jpsheehan/ence461-assignment2/README.md

# ence461_assignment2
2020 ENCE461 Assignment 2
