jpsheehan/ence461-assignment2/report/appendix.tex

\newpage
\appendix

\section*{Appendices}

\input{appendix-conditioning}

\input{appendix-thermal}

\input{appendix-schematic}

\input{appendix-bom}
