jpsheehan/ence461-assignment2/report/appendix-schematic.tex

\section{Schematic}
\label{ap:schematic}

The system schematic is included in the following page.

\includepdf[pages=1,fitpaper]{includes/ence461_kicad.pdf}
