jpsheehan/ence461-assignment2/report/design.tex

\section{Design}

\input{design-power-supply}

\input{design-amplifier-stage}

\input{design-microcontroller}

\input{design-communications}

\input{design-pcb-layout}
