jpsheehan/ence461-assignment2/report/report.tex

% !TEX TS-program = pdflatex
% !TEX encoding = UTF-8 Unicode

%%%%%%%%%%%%%%%%%%%%%%%%%%%%%%%%%%%%%%%%%%%%%%%%%%%%%%%%%%%%%%%%%%%%%%%%%%%%%%%%
%%%%%%%%                        DOCUMENT PREAMBLE                       %%%%%%%%
%%%%%%%%%%%%%%%%%%%%%%%%%%%%%%%%%%%%%%%%%%%%%%%%%%%%%%%%%%%%%%%%%%%%%%%%%%%%%%%%

\documentclass[12pt]{article}

\usepackage[utf8]{inputenc}

%%% PAGE DIMENSIONS
\usepackage{geometry}
\geometry{a4paper}
\geometry{margin=1in}

%%% PACKAGES
\usepackage{booktabs} 		% for much better looking tables
\usepackage{array} 			% for better arrays (eg matrices) in maths
\usepackage{paralist} 		% very flexible & customisable lists (eg. enumerate/itemize, etc.)
\usepackage{verbatim} 		% adds environment for commenting out blocks of text & for better verbatim
\usepackage{caption}
\usepackage{subcaption} 		% make it possible to include more than one captioned figure/table in a single float
\usepackage{amsmath}		% gives math environments like align, split, etc
\usepackage[parfill]{parskip} % Activate to begin paragraphs with an empty line rather than an indent
\usepackage{xcolor}			% adds support for different colors
\usepackage{float}			% adds support for floats
\usepackage{upgreek}		% greek letters
\usepackage{amssymb}
\usepackage{url}
\usepackage[binary-units]{siunitx}
\usepackage{pdfpages}

%%% Images
\usepackage{graphicx}		% allows us to include images
\graphicspath{ {./images/} }

%%% HEADERS & FOOTERS
\usepackage{fancyhdr} 		% This should be set AFTER setting up the page geometry
\pagestyle{fancy}
\renewcommand{\headrulewidth}{0pt} % customise the layout...
\lhead{}\chead{}\rhead{}
\lfoot{}\cfoot{\thepage}\rfoot{}

%%% ToC (table of contents) APPEARANCE
% \usepackage[nottoc,notlof,notlot]{tocbibind} % Put the bibliography in the ToC
% \usepackage[titles,subfigure]{tocloft} % Alter the style of the Table of Contents
% \renewcommand{\cftsecfont}{\rmfamily\mdseries\upshape}
% \renewcommand{\cftsecpagefont}{\rmfamily\mdseries\upshape} % No bold!

%%% Referencing and Bibliography
\usepackage[backend=bibtex, style=ieee]{biblatex}
\addbibresource{references.bib}

%%% Title Stuff
\title{ENCE461 Assignment 2}
\author{
	J.P. Sheehan \\
	M.F. Hamblyn \\
	\small{Group 36}
}
\date{\today}

%%%%%%%%%%%%%%%%%%%%%%%%%%%%%%%%%%%%%%%%%%%%%%%%%%%%%%%%%%%%%%%%%%%%%%%%%%%%%%%%
%%%%%%%%                          DOCUMENT BODY                         %%%%%%%%
%%%%%%%%%%%%%%%%%%%%%%%%%%%%%%%%%%%%%%%%%%%%%%%%%%%%%%%%%%%%%%%%%%%%%%%%%%%%%%%%

\begin{document}
\maketitle
\thispagestyle{empty}

\vfill
\begin{figure}[H]
	\centering
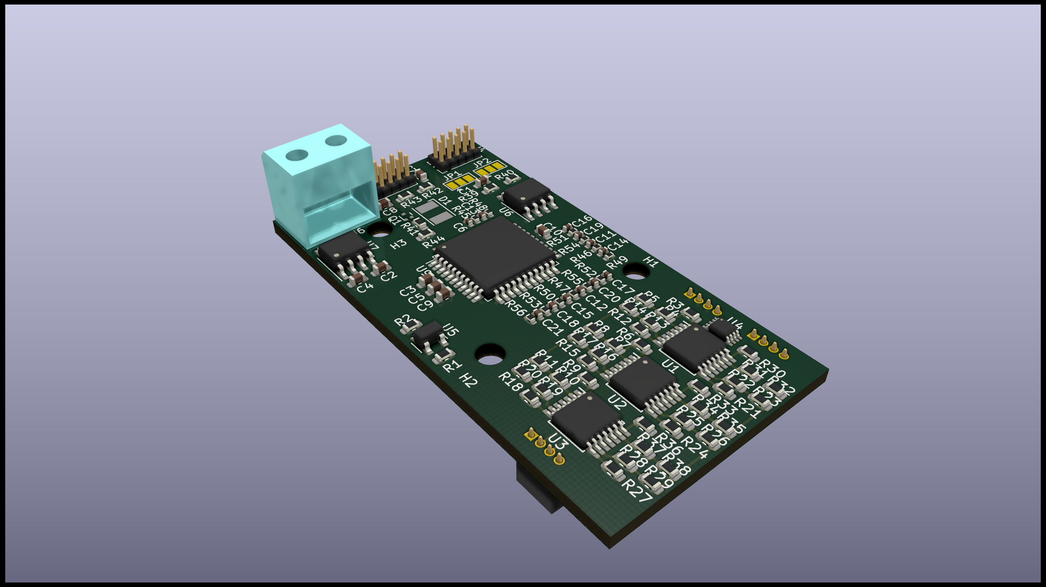
[picture p11: report/images/render.png]
	
	\label{fig:render}
\end{figure}
\vfill

\newpage

\input{introduction}

\input{design}

\input{conclusion}

%%%%%%%%%%%%%%%%%%%%%%%%%%%%%%%%%%%%%%%%%%%%%%%%%%%%%%%%%%%%%%%%%%%%%%%%%%%%%%%%
%%%%%%%%                           BIBLIOGRAPHY                         %%%%%%%%
%%%%%%%%%%%%%%%%%%%%%%%%%%%%%%%%%%%%%%%%%%%%%%%%%%%%%%%%%%%%%%%%%%%%%%%%%%%%%%%%

\printbibliography

% appendix
\input{appendix}

\end{document}
