jpsheehan/ence461-assignment2/report/introduction.tex

\section{Introduction}

Based on the provided requirements and subsequent clarifications, this design achieves:
\begin{enumerate}
	\item Reliable high speed, multi-node, communications.
	\item Minimal standby-mode power consumption.
	\item Ease of installation and maintainence. 
\end{enumerate}

The following sections outline the key design decisions made with a detailed analysis provided in the appendices.
