jpsheehan/ence461-assignment2/report/appendix-bom.tex

\section{Bill of Materials}
\label{ap:bom}

The bill of materials (BOM) including price list is included on the following page.
All prices are in NZD and all parts are sourced from Digi-Key\footnote{\url{https://www.digikey.co.nz/}}.

\includepdf[pages=1,fitpaper]{includes/BOM_cost.pdf}
