jpsheehan/ence461-assignment2/research/Parts.txt

Power Supply
Opamps are to be powered off 5V, a 2.5V (half rail) reference is required and we will assume, at this stage, microcontroller will be a 3.3V device. 
Therefore multiple supply rails are needed.
Optiom 1 - two seperate regulators
5V supply for the opamps and 1/2 rail.
May require the 5V and/or half rail to connect to micro ADC reference as well, but assume this rail does not require current.

5V supply to Opamp ADC amplifiers
Requirements
Linear device
5V output
>= 105 degrees
6V input.
RoHS comlaint
SMD
Ideally a low dropout voltage at full load. 
Minimum additional components
Missing parameter: ouput current.

Output current calculations
12 ADC channels and max current 2.7mA. Round up to 3mA gives some overhead.
Further opamp for the 2.5 volt reference. 13 x 3mA = 39mA.

Using the Digikey part sselector 
RoHSm datasheet, active part, 125 degrees, Vin max = 10V (allow some overhead for 6V input) gives:
1)
ADP1720ARMZ-R7
Datasheet ADP1720ARMZ-R7
Which has ouput current 50mA, VDO 275mV, -40 to 125 degree C
2)
Digikey 296-1364-2-ND, IC REG LINEAR 5V 100MA 8SOIC,
http://www.ti.com/general/docs/suppproductinfo.tsp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
3)
Digikey TC1054-5.0VCT713CT-ND, TC1054-5.0VCT713 
Datasheet http://ww1.microchip.com/downloads/en/DeviceDoc/21350E.pdf

Choose TC1054-5.0VCT713‎ because
Low drop out voltage (supply is only 6V and we need 5V out) typically 85mV max 120mV
It provies control pins. These may be required to shutdown the ADC amps into low power. (50uSec start up time for opamp)
Note that the ramp up time from shutdown to active is less than 100uSec. T start is therfore 100 + 50 = 150uSec
There are 100 and 150mA versions so if dicsover greater current is required this part can be uprated.

Thermal consderations.
PD worst case operating = (Vin - Vout) x Imax => (6.5-5)*50 = 75mW
PD max = (TJ - TA)/ thetaJA => (125-105) / 220 = 90.90mW
Thus PDMax > PD worst therfore device is suitable fro mthermal perspective.
However vin max = PD max/Imax + Vo => 90.909mW/50mA + 5 = 6.81V max.
Thus the supply input voltage must not exceed 6.8V, however Vin max is 6.5V.

93 units are required (assuming there is a need for 5V in the master unit)
Purhase of 100 units is reduces the cost by 20C and proves 7 spares
100x 0.46340 = $46.34

3.3V supply to microprocessor
Requirements
Linear devie since ADC is it main function.
3.3V output
>= 105 degrees
6V input.
RoHS compliantt
SMD
Minimum additional components
Mising parameter: ouput current
Output current calulations

If we assumed at this stage the micro and 3V3 periphials will comsume 500mA in total we can use CAT6219-330TDGT3 but 
 this is last time buy according to digikey and is likely overspecified.

Assume at this stage the micro and 3V3 periphials will comsume 150mA in total 
(micro, LED x 2, possbible buss chips)

Using the Digikey part sselector 
RoHSm datasheet, active part, 125 degrees, Vin max = 10V (allows overhead for 6V input) gives 

Selet the following part due to
Minimum external compents, on board protection.
Digikey 296-11021-1-ND, TPS76333DBVR
http://www.ti.com/lit/ds/symlink/tps763.pdf?HQS=TI-null-null-digikeymode-df-pf-null-wwe&ts=1590036136348
It is known that there are 6V versions and also 250mA versions whcih may have a similar form factor, 
 so the part could be changed if higher Iout is required.

Thermal consderations.
PD worst case operating = (Vin - Vout) x Imax => (6.5-3.3)V * 150mA = 480mW
PD max = (TJ - TA)/ thetaJA => (125-105) / 205.3 = 97.41 mW
Thus PDMax < PD worst therfore device is not suitable.

TPS76633, TPD706-150 and others => not suitable

Check
Digikey 296-19675-1-ND, TPS71733DCKR
Tj = Tt + gamma?jt * PD max => 105 + 2.7*480mW = 106.296 less than Toperating max = 125 
Tj = Tb + gamma?jb * PD max => 105 + 40.9* 480mW = 124.632 degress just less than Toperating max = 125 
This is on the limit at 6.5V input 
At 6.0 Vin Tj = 121 degrees - still less than Toperating max = 125 
VDO = 300mV worst case.
100 x 1.00190 =  $100.19 

Option 2 - combined 5V and 3V3 supplies
Maybe later

Op-Amps:
========

OPAMP FOR VIRTUAL GROUND: 296-51364-1-ND (digikey)

Option 1
Need 12 opamp circuits for each slave board.
and one more for reliable 1/2 rail.

The LMV324AIPWR has four opamp circuits per package.
So we only need 12 / 4 * 92 = 368 of these.
The part number on Digi-Key is [296-51366-1-ND ](https://www.digikey.co.nz/product-detail/en/texas-instruments/LMV324AIPWR/296-51366-1-ND/9745730).
For 368, we have a buy price of $0.36704 per unit

This part doesn't have an enable line so we will have to also use a mosfet to drive the positive supply voltage to ground to disable. 
This chip has a 50 us startup time.
Gets to within 20mV of rail voltage.

150uA * 13 devices = 1.95mA == 2mA ??

Option 2
MCP632T-E/MFCT-ND provides chip enable/disable function and T operating of 125 degress. Tmax is 150 degrees so based on the likely current ouputs with no 
 ouptput limiting resistor comfortabel meets the PD max and PO max thermal considerations.
Optimies for single supply rail.
Input current is nomianll6 2.5mA per channel and 3.6mA max per channel.
Enable time is 4.5uSec.
3.6mA x 13 = 46.8 mA - within 5V regulator specification.
Checking pricing 368 dual units at 1.483 ea is the lowest cost option at $545.70. 4 Opamps per board, 1 ch unused. (could put jumpers on this)
Gets to within 40mV of rail voltage.

Revised system
1)
5V devices		worst case	typical
ADC amplifiers	13 x 03mA	39	.6mA	9.75
Half rail	01 x 01mA	01	01	01
CAN driver	01 x 70mA	70	47mA	47
Hex inverter	01 x 50mA	50	50mA	50
=======================================================
Total				118		110

Thermal consderations - TPS76950DBVT
PD worst case operating = (Vin - Vout) x Imax => (6-5)*100m = 100mW
PD max = (TJ - TA)/ thetaJA => (125-105) / 180 = 110mW [Board must be design for high temperature operation JEDEC HighK (2s2p)] 
Thus PDMax > PD worst therfore device is suitable fro mthermal perspective.
But 110 > 100mA

2)
5V devices		worst case	typical
ADC amplifiers	13 x 03mA	39	.6mA	9.75
Half rail	01 x 01mA	01	01	01
CAN driver	01 x 70mA	70	47mA	47
Hex inverter	01 x 50mA	50	50mA	50
=======================================================
Total				118		110

Thermal consderations - TPS717DRV(WSON

PD worst case operating = (Vin - Vout) x Imax => (6-5)*110m = 110mW
Jt = Tj + Tt*PDmax => 105 + 2.7  x 120mW = 105 degrees C
Jt = Tj + Tt*PDmax => 105 + 40.9 x 120mW = 109 degrees C
Tj < Tj MAX (125 degrees) therfore device is suitable fro mthermal perspective.

3)
3V3 devices		worst case	typical
micro		01 x 40mA	40	01 x 50mA	30
LEDS		02 x 05mA	10	02 x 05mA	10
===========================================================
Total				50			40

PD worst case operating = (Vin - Vout) x Imax => (6-3.3)*50m = 135mW
PD Max = (Toperating-Tambient)/T JA => (125-105)/65 = 307mW
[Board must be design for high temperature operation JEDEC HighK (2s2p)] 

3V3 devices		worst case	typical
micro		01 x 80mA	80	01 x 50mA	50 30
LEDS		01 x 19mA	20	01 x 19mA	19
===========================================================
Total				100			70

TPS71433DRV
PD worst case = (Vin - Vout) x Imax => (6-3.3)*70m = 189mW
PD worst typical operating = (Vin - Vout) x Imax => (6-3.3)*30m = 81mW
PD max operating = (Vin - Vout) x Imax => (6-3.3)*80m = 216mW
[Board must be designed for high temperature operation JEDEC HighK (2s2p)] 

5V3 devices		worst case	typical
micro		11 x 40mA	40	30mA	30
LEDS		02 x 10mA	20	05mA	10
=======================================================
Total				60		40

Revision 17

CAN Transceiver
===============
NCV7344D13R2GOSCT-ND (digikey)

LED Indication
==============
Red LED: 475-2516-1-ND (digikey)
P MOSFET: RZM001P02T2LCT-ND (digikey)

Microcontroller
===============
ATSAMC21N17A-ANTCT-ND (digikey)

5V Regulator
============
Option 1)
Devices		worst case		typical
ADC amplifiers	13 x 03mA	39	.75mA	9.75
Half rail	01 x 01mA	01	01mA	01
CAN driver	01 x 70mA	70	47mA	47
Hex inverter	01 x 50mA	50	50mA	50
Micro		01 x 50mA	50	20mA	20
LED		01 x 19mA	19	19mA	19
=======================================================
Total				118		145.75

Thermal design TPS71750QDRVRQ1‎
PD worst case operating = (Vin - Vout) x Imax => (6-5)*145.75 = 145.75mW
Tj = Ta + Tt*PDmax => 105 + 2.7  x 146mW = 105.39 degrees C
Tj = Ta + Tt*PDmax => 105 + 40.9 x 146mW = 110 degrees C
Tj > Tj MAX (125 degrees) :. device is suitable from thermal perspective.
100 x 0.80411 = $80.41

option 2)
Devices		worst case		typical
ADC amplifiers	13 x 03mA	39	.75mA	9.75
Half rail	01 x 01mA	01	01mA	01
CAN driver	01 x 70mA	70	47mA	47
Micro		01 x 50mA	50	20mA	20
LED		01 x 19mA	19	19mA	19
=======================================================
Total				118		95.75
PD worst case operating = (Vin - Vout) x Imax => (6-5)*95.75 = 95.75mW
Tj > Tj MAX (125 degrees) (current reduced :. power reduced) :. device is suitable from thermal perspective.
100 x 0.80411 = $80.41

option 3)
Devices		worst case		typical
ADC amplifiers	13 x 03mA	39	.75mA	9.75
Half rail	01 x 01mA	01	.5mA	.5
CAN driver	01 x 70mA	70	47mA	47
Micro		01 x 50mA	50	20mA	20
LED		01 x 19mA	19	19mA	19
=======================================================
Total				118		95.25

PD worst case operating = (Vin - Vout) x Imax => (6-5) x 95.25 = 95.25mW
PD max = (T max - T ambient) / Theta JA => (125-105) / 65 = 317.46mW
PD < PDmax :. device is ok.
@ PD = (6-5)*145.75 = 145.75mW < PD max
100 x MIC5202-5.0YMM @ 2.33750 = 233.75 digikey
OR
100 x MIC5210-5.0YMM @ 1.87 = $187
!st option = less physcial space, 2nd option lower price.
a 5V amps on 1 rail, micro and CAN on other
b 5V amps & hex inverter 1 rail, micro and CAN on other
c 5V amps, hex and CAN, micro on other use CAN wake on Rx 

Cables and Connectors
============================================================

Power
------
150mA x 92 devices = 13.8 amps = > 19.2A
Split into 4 termainton points = 3.45 each at the point of supply. 4.8A if later expandto 128 nodes.
rATE SUPPLKY CONNECTORS AT 5a EACH.
Rate PSU cable to 2.9A based that cable will not run at full current for extended duration and 
only the sectsion of cable nearest the supply wil need to carry full current.
2.9A = 17AWG = 1.15mm = 1.04mm^2
Split power rails into 4 feeders. 92/4 = 23. 22 board interconnnects per feeder @ 160mm each = 3520mm = 3.52m.
Assume master is 10m from motherboard: 10m x 4feeders = 40m
40m + 3.52m = 43.52m => 50m 
Mouser: 
(2x 25m roll black + 2x 25m roll red or 2x 100 ft black, 2x 100ft red)
4x 148.50 (per 100ft) = $594
Digikey: 
(1x 50m roll black, 1x 50m roll red) 
2x 50m @ 195.55000 = $191.10
67010 BK321 Black
67010 RD321 Red

Choose
TB002-500-02BE .38930  x 100
based on price and requiremt to get 2x 17AWG conductors into the terminal block.

Alternative not used.
Plug 	691381000002 2.34860 x 100
Socket	691382000002 0.75070 x 100

Data
-----
Ribbon cable chosen for easy interconect, and speed.
10 way is more readily avialbel than 8 way.
10way IDC ribbon cable, crimped strain relief plug, through hole PCB mount, 0.05 inch 1.27 mm pitch
Split buss into 2 feeders. 92/2 = 46 units. 45 interconecnted at 160mm = 1360mm = 7.36m
Assume master is 10m from motherboard: 10m x 2 feeders = 20m
20m + 7.36m = 27.36 => 30.48m (100 ft)
Plug		3230-10-0103-00		$1.87 x 100
PCB socket	3221-10-0100-00		$.852 x 100
<<<<<<< HEAD
Cable		3756/10 100 		$1.15760 x 25

=======
Cable		3756/10 100 		$46.05000 x 1 = $46.05000
>>>>>>> 66b855b4c92f8af61c3a72c46185c5a99e1565bd
	Conductors size is 30AWG (nominally 270kHz for 100% skin depth)
	Actual cable uses 7 strands of 38AWG (nominally 1750kHz for 100% skin depth)
	Z characterist 138 ohms balenced, velocity factor 74%, velocity of prop 4.53nSec/m.
	(have chosen a cable with slight higher charestic impeedence to achvieve a signhlt higher voelcity factor, knowing
	 that the bus is near end and far end terminated to 120 ohm this actually presenr 130 ohm parallel.
	If needed this could be reduce this to 120 ohm by changing the buss termial reistor values.)
	coudl reduce the values of the resistors,)

Choose 00 AA 00 BB 00 (1-10) (2x buss conducters enclised surrounded by signal ground.
	This is chosen so that the cabel can be reversed without damage - only buss B is conencted in stead of buss A.
	Further, each data conductor has an signal gound condcutor next to it to minmise indcued noise.  
	(Optiontally termina lsignla ground to power groudn at the slave borads using a approate capacitor.)
Not 0 AA 0 BB 0 CC 0 (3 buss) or +0 AA 00 BB 0+ (power on bus)

The master unit.
4 power supply terminal blocks or simalr rated to 5A.
2 CAN bus ribbon cable terminations.

Jesse's Power Connector Search:
===============================

102-6145-ND about 0.38 each for 100
