jpsheehan/ence461-assignment2/ence461_kicad/models/terminalblock.FCStd

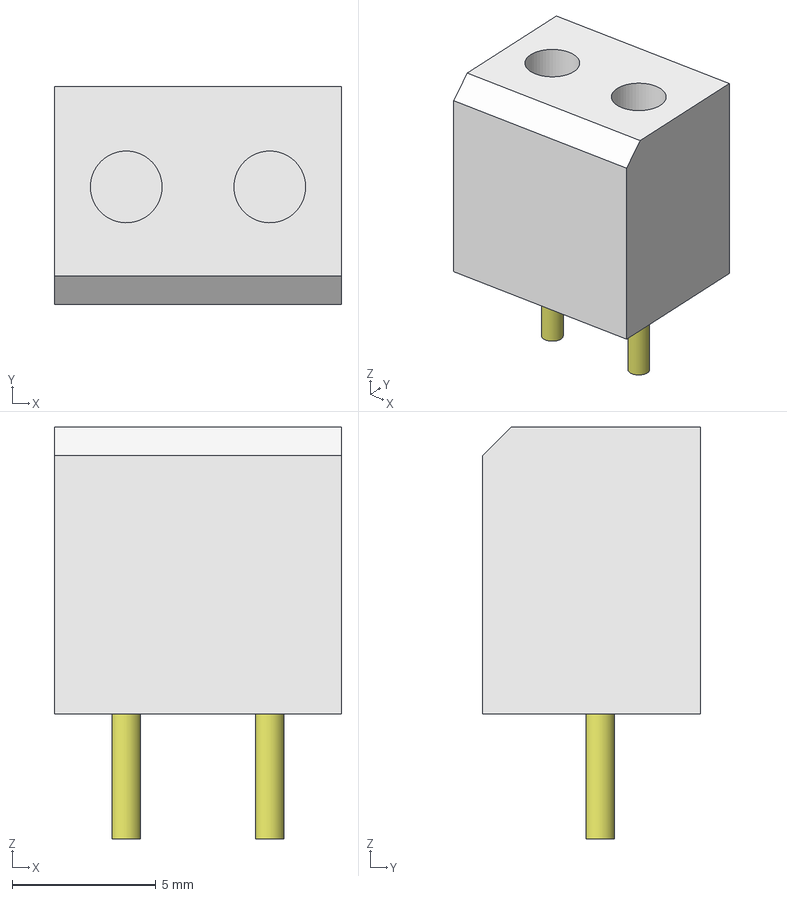
[picture p13: CAD file, 2020-05-24]
ence461_kicad/models/terminalblock.FCStd
10.0 x 7.60 x 14.3 mm
