jpsheehan/ence461-assignment2/report/includes/ence461_kicad.pdf

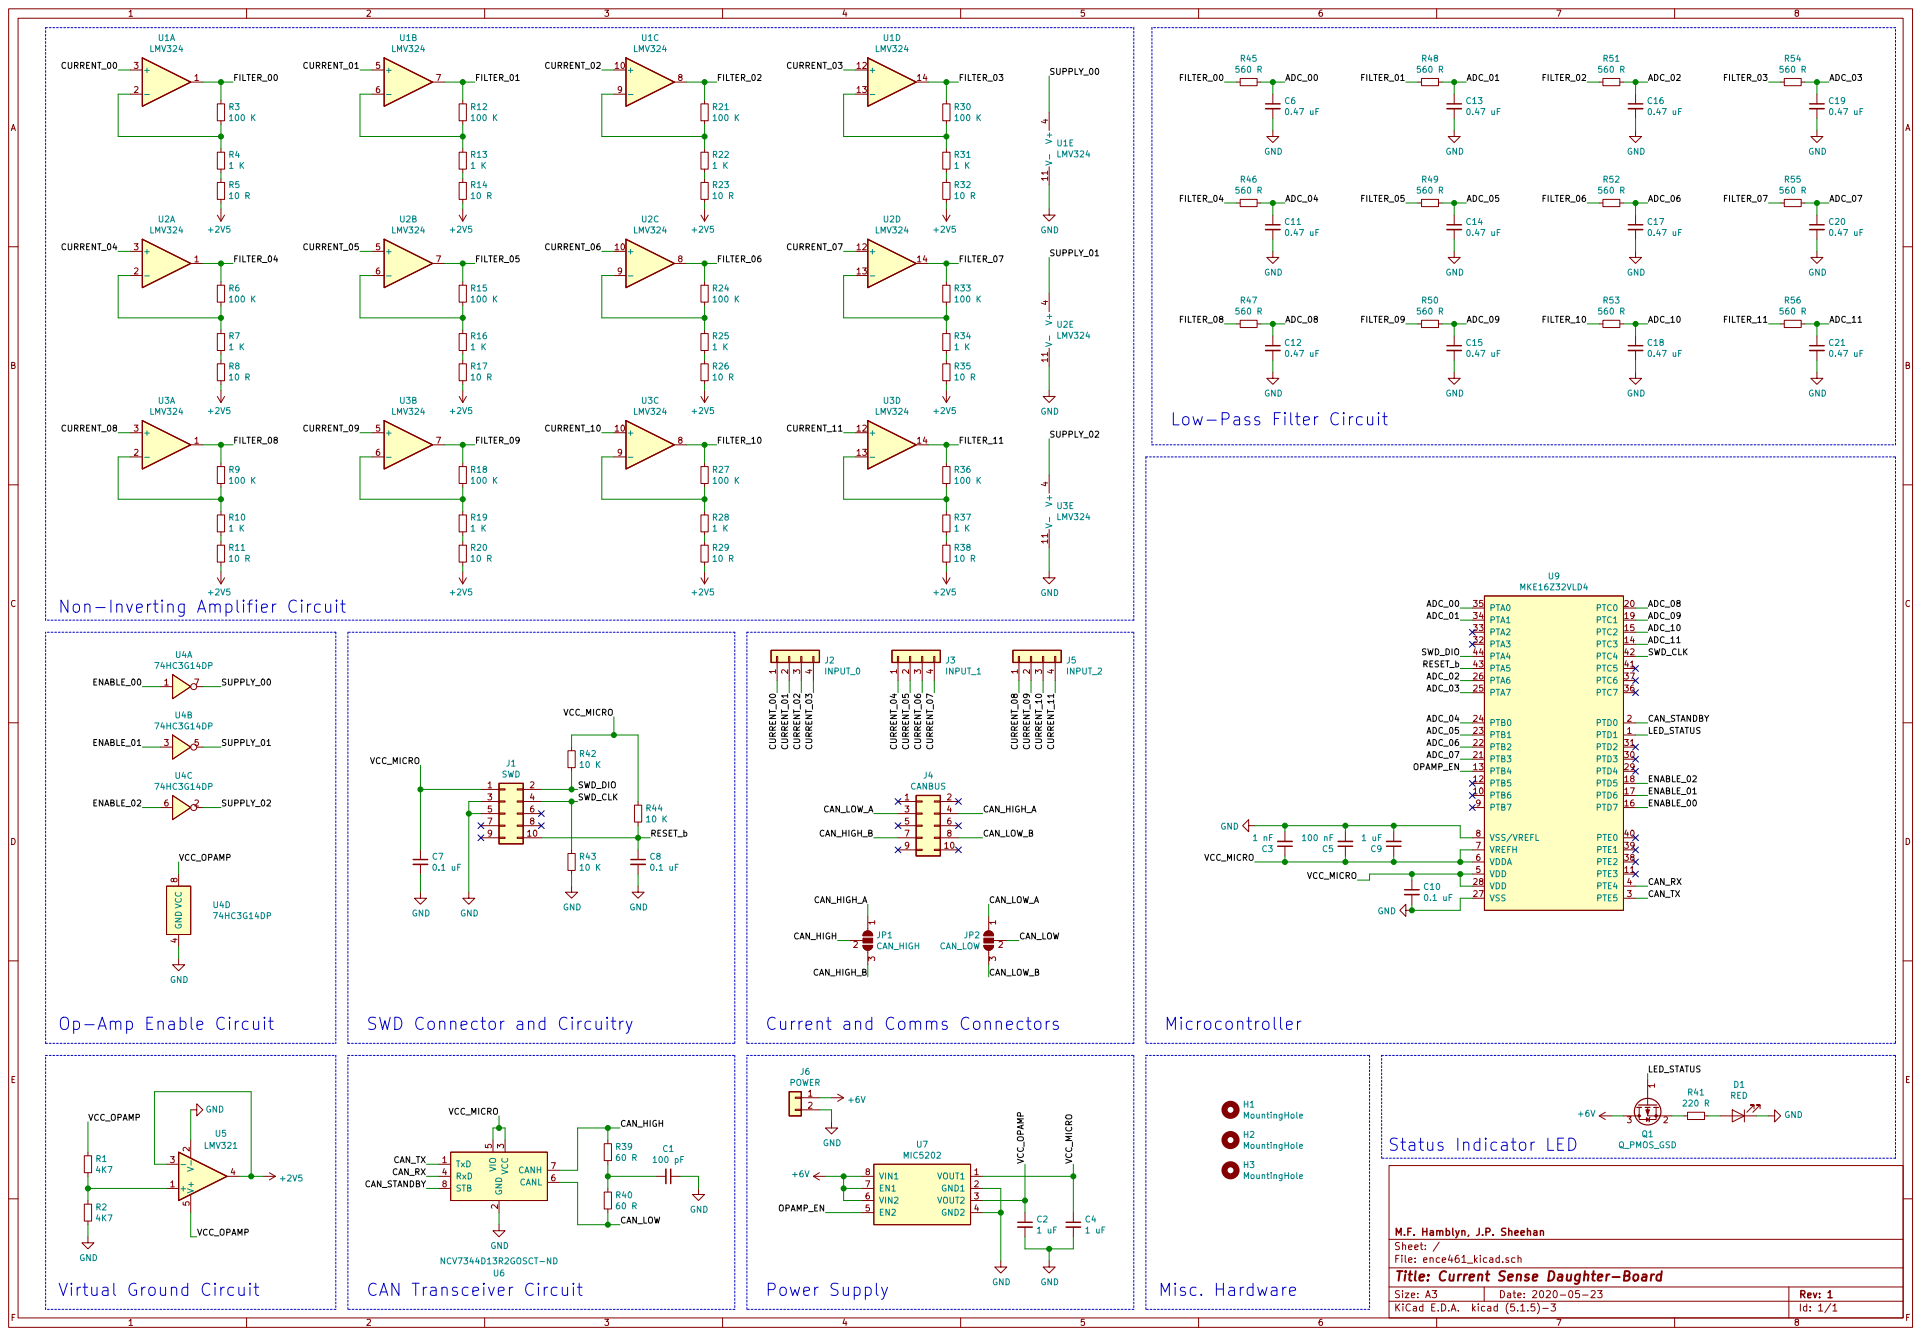
[picture p14: page 1]

Low-Pass Filter Circuit

LED_STATUS Non-Inverting Amplifier Circuit

5 CANL 6 CANH 7 STB 8 U6 NCV7344D13R2GOSCT-ND GNDGND

Current and Comms Connectors

File: ence461_kicad.sch Sheet: / M.F. Hamblyn, J.P. Sheehan

Id: 1/1 Title: Current Sense Daughter-Board
