jpsheehan/ence461-assignment2/ence461_kicad/ence461_kicad.kicad_pcb

## KiCad design ence461_kicad/ence461_kicad.kicad_pcb (2020-05-25)

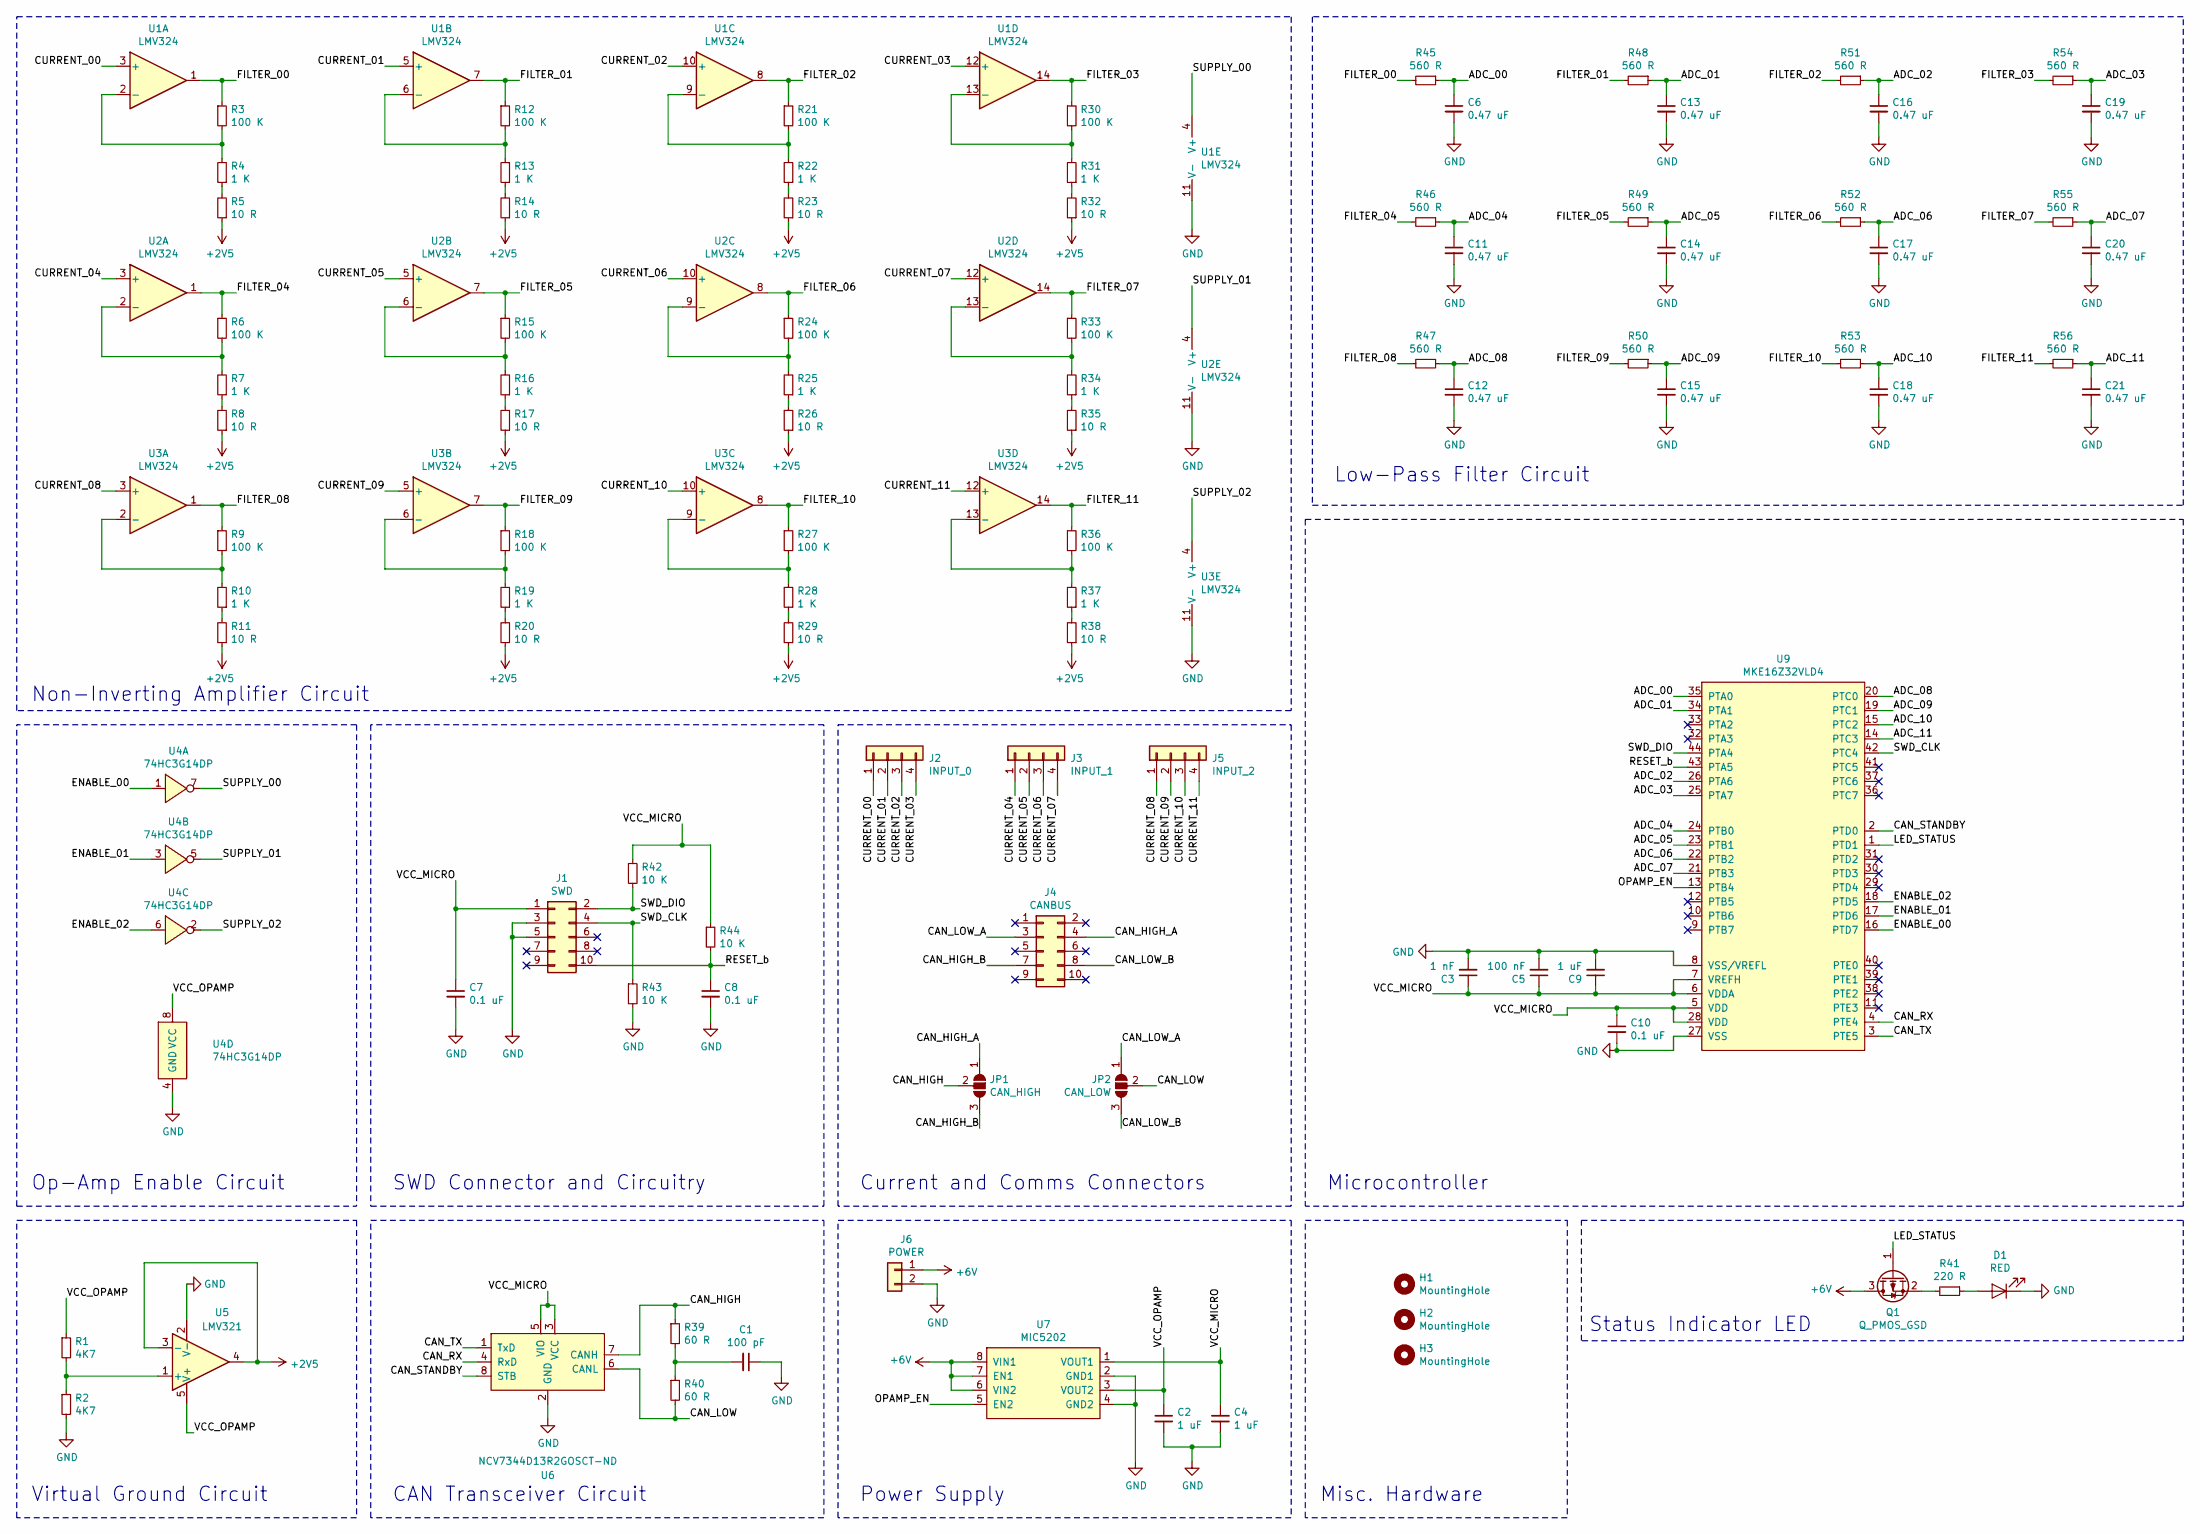
[picture p15: schematic ence461_kicad.sch, Current Sense Slave]

Parts:
C1: 100 pF; C_0603_1608Metric
C2, C4, C9: 1 uF; C_0603_1608Metric
C3: 1 nF; C_0603_1608Metric
C5: 100 nF; C_0603_1608Metric
C6, C11, C12, C13, C14, C15, C16, C17, C18, C19, C20, C21: 0.47 uF; C_0402_1005Metric
C7, C8, C10: 0.1 uF; C_0603_1608Metric
D1: RED; LED_PLCC-2
H1, H2, H3: MountingHole; MountingHole_3mm
J1: SWD; PinHeader_2x05_P1.27mm_Vertical
J2: INPUT_0; PinSocket_1x04_P1.27mm_Vertical
J3: INPUT_1; PinSocket_1x04_P1.27mm_Vertical
J4: CANBUS; PinHeader_2x05_P1.27mm_Vertical
J5: INPUT_2; PinSocket_1x04_P1.27mm_Vertical
J6: POWER; TB002-500
JP1: CAN_HIGH; SolderJumper-3_P1.3mm_Open_Pad1.0x1.5mm
JP2: CAN_LOW; SolderJumper-3_P1.3mm_Open_Pad1.0x1.5mm
Q1: Q_PMOS_GSD; SOT-723
R1, R2: 4K7; R_0603_1608Metric
R3, R6, R9, R12, R15, R18, R21, R24, R27, R30, R33, R36: 100 K; R_0603_1608Metric
R4, R7, R10, R13, R16, R19, R22, R25, R28, R31, R34, R37: 1 K; R_0603_1608Metric
R5, R8, R11, R14, R17, R20, R23, R26, R29, R32, R35, R38: 10 R; R_0603_1608Metric
R39, R40: 60 R; R_0603_1608Metric
R41: 220 R; R_0603_1608Metric
R42, R43, R44: 10 K; R_0603_1608Metric
R45, R46, R47, R48, R49, R50, R51, R52, R53, R54, R55, R56: 560 R; R_0402_1005Metric
U1, U2, U3: LMV324; TSSOP-14_4.4x5mm_P0.65mm
U4: 74HC3G14DP; VSSOP-8_2.3x2mm_P0.5mm
U5: LMV321; SOT-23-5
U6: NCV7344D13R2GOSCT-ND; SOIC-8_3.9x4.9mm_P1.27mm
U7: MIC5202; SOIC-8_3.9x4.9mm_P1.27mm
U9: MKE16Z32VLD4; LQFP-44_10x10mm_P0.8mm

Connections:
+2V5: R5.1, R8.1, R11.1, R14.1, R17.1, R20.1, R23.1, R26.1, R29.1, R32.1, R35.1, R38.1, U5.3 (-), U5.4
+6V: J6.1, Q1.3 (D), U7.6 (VIN2), U7.7 (EN1), U7.8 (VIN1)
/ADC_00: C6.1, R45.1, U9.35 (PTA0)
/ADC_01: C13.1, R48.1, U9.34 (PTA1)
/ADC_02: C16.1, R51.1, U9.26 (PTA6)
/ADC_03: C19.1, R54.1, U9.25 (PTA7)
/ADC_04: C11.1, R46.1, U9.24 (PTB0)
/ADC_05: C14.1, R49.1, U9.23 (PTB1)
/ADC_06: C17.1, R52.1, U9.22 (PTB2)
/ADC_07: C20.1, R55.1, U9.21 (PTB3)
/ADC_08: C12.1, R47.1, U9.20 (PTC0)
/ADC_09: C15.1, R50.1, U9.19 (PTC1)
/ADC_10: C18.1, R53.1, U9.15 (PTC2)
/ADC_11: C21.1, R56.1, U9.14 (PTC3)
/CAN_HIGH: JP1.2 (C), R39.1, U6.7 (CANH)
/CAN_HIGH_A: J4.4, JP1.1 (A)
/CAN_HIGH_B: J4.7, JP1.3 (B)
/CAN_LOW: JP2.2 (C), R40.2, U6.6 (CANL)
/CAN_LOW_A: J4.3, JP2.1 (A)
/CAN_LOW_B: J4.8, JP2.3 (B)
/CAN_RX: U6.4 (RxD), U9.4 (PTE4)
/CAN_STANDBY: U6.8 (STB), U9.2 (PTD0)
/CAN_TX: U6.1 (TxD), U9.3 (PTE5)
/CURRENT_00: J2.1, U1.3 (+)
/CURRENT_01: J2.2, U1.5 (+)
/CURRENT_02: J2.3, U1.10 (+)
/CURRENT_03: J2.4, U1.12 (+)
/CURRENT_04: J3.1, U2.3 (+)
/CURRENT_05: J3.2, U2.5 (+)
/CURRENT_06: J3.3, U2.10 (+)
/CURRENT_07: J3.4, U2.12 (+)
/CURRENT_08: J5.1, U3.3 (+)
/CURRENT_09: J5.2, U3.5 (+)
/CURRENT_10: J5.3, U3.10 (+)
/CURRENT_11: J5.4, U3.12 (+)
/ENABLE_00: U4.1, U9.16 (PTD7)
/ENABLE_01: U4.3, U9.17 (PTD6)
/ENABLE_02: U4.6, U9.18 (PTD5)
/FILTER_00: R3.1, R45.2, U1.1
/FILTER_01: R12.1, R48.2, U1.7
/FILTER_02: R21.1, R51.2, U1.8
/FILTER_03: R30.1, R54.2, U1.14
/FILTER_04: R6.1, R46.2, U2.1
/FILTER_05: R15.1, R49.2, U2.7
/FILTER_06: R24.1, R52.2, U2.8
/FILTER_07: R33.1, R55.2, U2.14
/FILTER_08: R9.1, R47.2, U3.1
/FILTER_09: R18.1, R50.2, U3.7
/FILTER_10: R27.1, R53.2, U3.8
/FILTER_11: R36.1, R56.2, U3.14
/LED_STATUS: Q1.1 (G), U9.1 (PTD1)
/OPAMP_EN: U7.5 (EN2), U9.13 (PTB4)
/RESET_b: C8.1, J1.10, R44.2, U9.43 (PTA5)
/SUPPLY_00: U1.4 (V+), U4.7
/SUPPLY_01: U2.4 (V+), U4.5
/SUPPLY_02: U3.4 (V+), U4.2
/SWD_CLK: J1.4, R43.1, U9.42 (PTC4)
/SWD_DIO: J1.2, R42.2, U9.44 (PTA4)
/VCC_MICRO: C3.1, C4.1, C5.1, C7.1, C9.1, C10.1, J1.1, R42.1, R44.1, U6.3 (VCC), U6.5 (VIO), U7.1 (VOUT1), U9.5 (VDD), U9.6 (VDDA), U9.7 (VREFH), U9.28 (VDD)
/VCC_OPAMP: C2.1, R1.1, U4.8 (VCC), U5.5 (V+), U7.3 (VOUT2)
GND: C1.1, C2.2, C3.2, C4.2, C5.2, C6.2, C7.2, C8.2, C9.2, C10.2, C11.2, C12.2, C13.2, C14.2, C15.2, C16.2, C17.2, C18.2, C19.2, C20.2, C21.2, D1.1 (K), J1.3, J1.5, J6.2, R2.2, R43.2, U1.11 (V-), U2.11 (V-), U3.11 (V-), U4.4 (GND), U5.2 (V-), U6.2 (GND), U7.2 (GND1), U7.4 (GND2), U9.8 (VSS/VREFL), U9.27 (VSS)
unnamed: C1.2, R39.2, R40.1
unnamed: D1.2 (A), R41.1
unnamed: Q1.2 (S), R41.2
unnamed: R1.2, R2.1, U5.1 (+)
unnamed: R3.2, R4.2, U1.2 (-)
unnamed: R4.1, R5.2
unnamed: R6.2, R7.2, U2.2 (-)
unnamed: R7.1, R8.2
unnamed: R10.1, R11.2
unnamed: R9.2, R10.2, U3.2 (-)
unnamed: R12.2, R13.2, U1.6 (-)
unnamed: R13.1, R14.2
unnamed: R15.2, R16.2, U2.6 (-)
unnamed: R16.1, R17.2
unnamed: R18.2, R19.2, U3.6 (-)
unnamed: R19.1, R20.2
unnamed: R21.2, R22.2, U1.9 (-)
unnamed: R22.1, R23.2
unnamed: R24.2, R25.2, U2.9 (-)
unnamed: R25.1, R26.2
unnamed: R27.2, R28.2, U3.9 (-)
unnamed: R28.1, R29.2
unnamed: R30.2, R31.2, U1.13 (-)
unnamed: R31.1, R32.2
unnamed: R33.2, R34.2, U2.13 (-)
unnamed: R34.1, R35.2
unnamed: R36.2, R37.2, U3.13 (-)
unnamed: R37.1, R38.2

Notes on the sheet:
Op-Amp Enable Circuit
Non-Inverting Amplifier Circuit
Virtual Ground Circuit
CAN Transceiver Circuit
Power Supply
SWD Connector and Circuitry
Current and Comms Connectors
Status Indicator LED
Low-Pass Filter Circuit
Misc. Hardware
Microcontroller

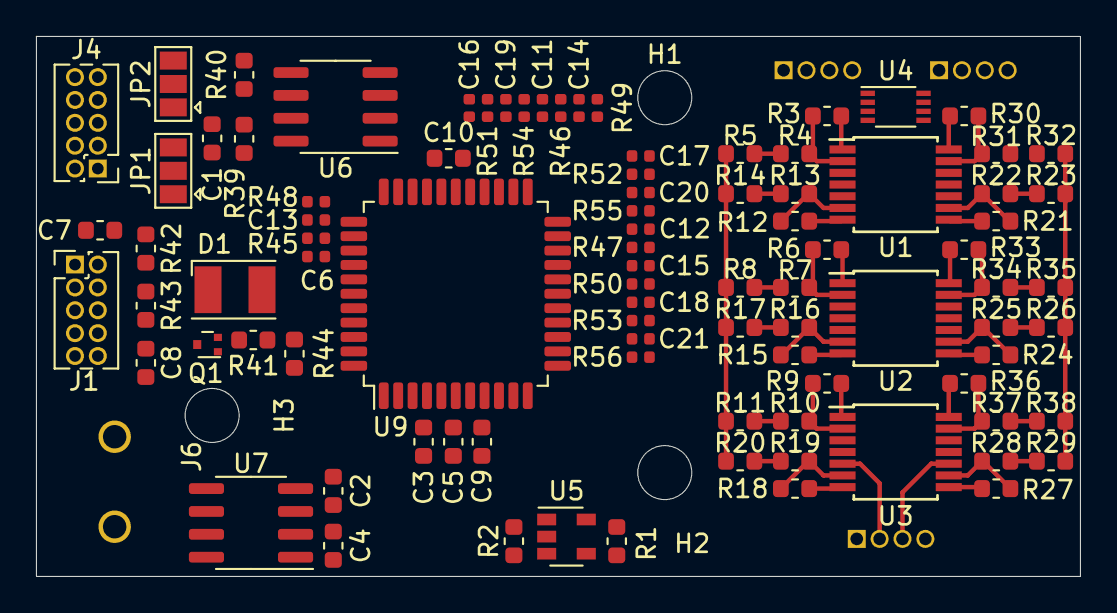
[picture p16: board ence461_kicad.kicad_pcb from above]

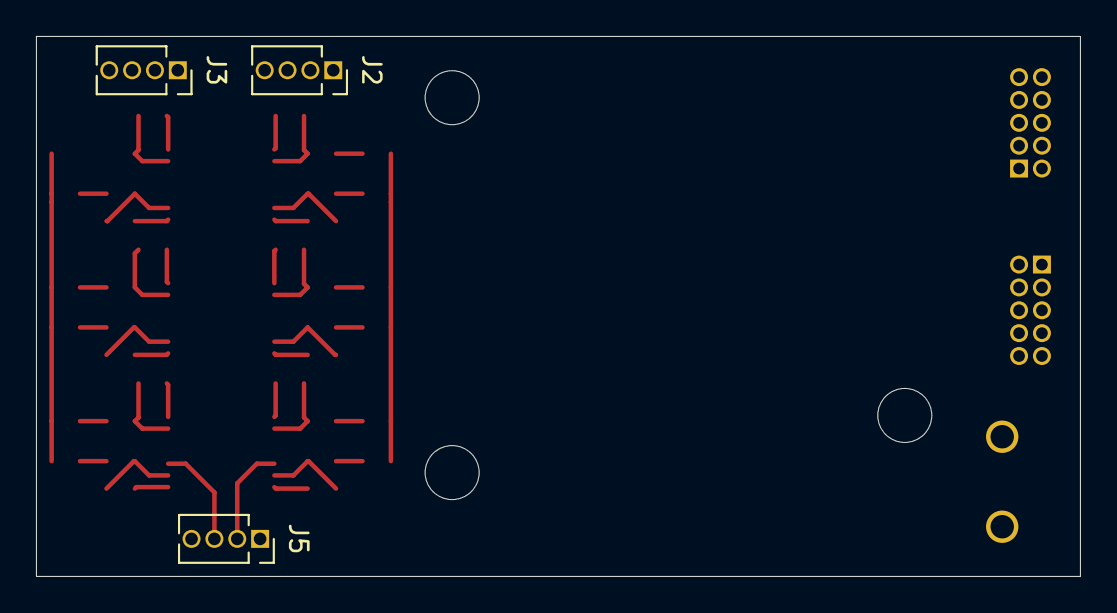
[picture p17: board ence461_kicad.kicad_pcb from below]

Board: 2 copper layers, 58.0 x 30.0 mm, 98 parts (3 on the bottom side), 89 nets.
