jpsheehan/ence461-assignment2/(commit log)

2020-05-21 Linear 5V regulator datasheets
2020-05-21 PSU option 2 - combined micro/ADC
2020-05-21 Added empty kicad project.
    [ence461_kicad.kicad_pcb, ence461_kicad.sch]
2020-05-21 Regulator thermal calcs & pricing
2020-05-21 Why doesn't Parts track
2020-05-22 Added non-inverting op-amp circuits.
    [ence461_kicad.sch]
2020-05-22 Added circuit images.
2020-05-22 Added op amps to schematic. Specced an opamp for virtual gnd.
    [ence461_kicad.sch]
2020-05-22 Buss comms
    [BussOptions.xlsx]
2020-05-22 Update buss topology
    [BussOptions.xlsx]
2020-05-22 Added hex inverter stuff
    [ence461_kicad.sch]
2020-05-22 Respecced the inverter
    [ence461_kicad.sch]
2020-05-22 Added CAN transceiver symbol to schematic.
    [ence461_kicad.sch]
2020-05-22 Update 3V# regulator
2020-05-22 Added TPS717 symbol to schematic.
    [ence461_kicad.sch]
2020-05-22 Added TPS714 supply.
    [ence461_kicad.sch]
2020-05-22 Added stubs for external connectors.
    [ence461_kicad.sch]
2020-05-23 Added some stubs for micro gpio
    [ence461_kicad.sch]
2020-05-23 Update comms selection
    [BussOptions.xlsx]
2020-05-23 3V3 thermal calc, explain design preference
    [ence461_kicad.sch]
2020-05-23 Added an LED, not 100% sure tho
2020-05-23 Added LED status indicator.
    [ence461_kicad.sch]
2020-05-23 Added LED to schematic.
    [ence461_kicad.sch]
2020-05-23 Added a reference to virtual ground op-amp
2020-05-23 Added micro info.
    [ence461_kicad.kicad_pcb, ence461_kicad.sch]
2020-05-23 Update comms & regulators
    [BussOptions.xlsx]
2020-05-23 New 5V PSU design, remove old PSU pdf's
2020-05-23 Starting cables, connectors, update buss sheet
    [BussOptions.xlsx]
2020-05-23 Added micro to schematic. Laid out.
    [ence461_kicad.kicad_pcb, ence461_kicad.sch]
2020-05-23 Forgot to save.
    [ence461_kicad.sch]
2020-05-23 Added symbol for new power supply to schematic.
    [ence461_kicad.kicad_pcb, ence461_kicad.sch]
2020-05-24 Changed amplifier gain to 141
    [ence461_kicad.sch]
2020-05-24 Added RC filtering.
    [ence461_kicad.kicad_pcb, ence461_kicad.sch]
2020-05-24 Spec'd data cable and connectors
2020-05-24 Almost there!
    [ence461_kicad.kicad_pcb, ence461_kicad.sch]
2020-05-24 Added datasheet for power connector.
2020-05-24 Finished layout.
    [ence461_kicad.kicad_pcb, ence461_kicad.sch]
2020-05-24 Added a model for the power connector.
    [TERMINALBLOCK.step, ence461_kicad.kicad_pcb, terminalblock.FCStd]
2020-05-24 Power cable & parts
2020-05-24 Removed some temp files.
    [TERMINALBLOCK.step]
2020-05-24 Added power connector.
2020-05-24 notes on data cable
2020-05-24 Power supply section started
2020-05-25 Finish PSU section and update buss options
    [BussOptions.xlsx]
2020-05-25 Changed gain stage to equal 100
    [ence461_kicad.sch]
2020-05-25 Added schematics for diagrams. Fixed virtual ground mistake.
    [diagrams_for_report.kicad_pcb, diagrams_for_report.sch, ence461_kicad.kicad_pcb, ence461_kicad.sch]
2020-05-25 Added PCB layout section.
2020-05-25 Added schematic to appendix.
2020-05-25 Added bom
    [bom.csv]
2020-05-25 Update schematic title
    [ence461_kicad.sch]
2020-05-25 BOM in pdf
    [bom.csv]
2020-05-25 now the bom in pdf
2020-05-25 Words on thermal and power supply.
2020-05-25 Fix current consumption words
